brandonbraun653/OrbitESC/.kilo/commands/review-diff.md

---
name: review-diff
description: Review the current staged or unstaged diff with the RDD Reviewer.
argument-hint: Optionally specify staged, unstaged, or a path
agent: RDD Reviewer
---

Review current diff if no explicit files provided.

- Keep standard seven-dimension review format.
- Scope findings to diff + directly adjacent evidence.
- Targeted read-only analysis or narrow tests only when they reduce uncertainty.
- Surface req, tagging, traceability regressions alongside normal quality findings.
