brandonbraun653/OrbitESC/notebook/attachments/Pasted image 20251213105923.png

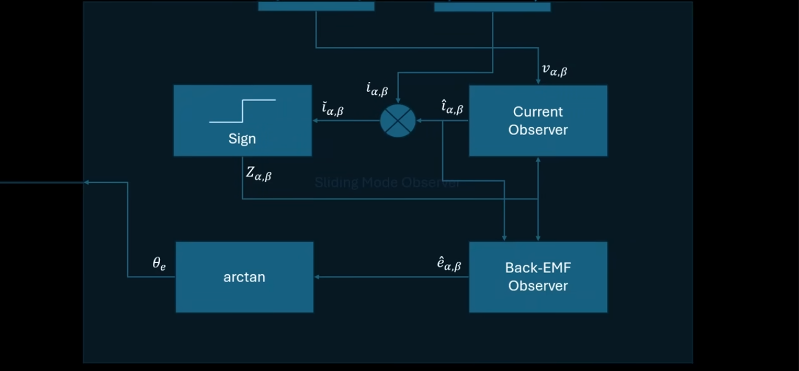
notebook/attachments/Pasted image 20251213105923.png
