brandonbraun653/OrbitESC/notebook/attachments/Pasted image 20251213110534.png

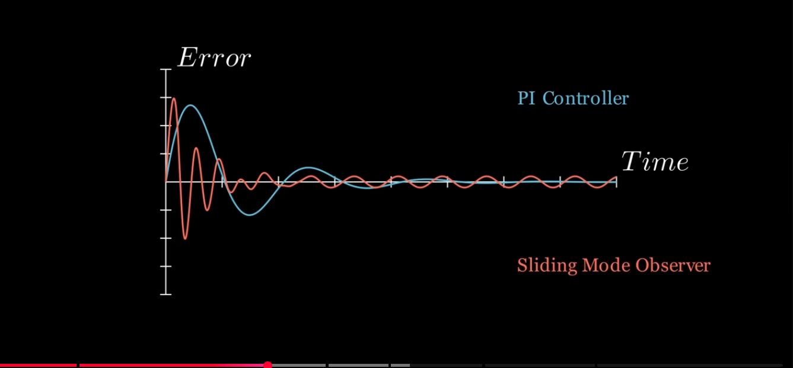
notebook/attachments/Pasted image 20251213110534.png
