brandonbraun653/OrbitESC/hw/pcb/OrbitESC_V3/validation/OrbitESC_BOMCheckList.ods

Reference | Value | Footprint | DigiKey | LCSC | Qty
U7 | AP62200Z6-7 | Package_TO_SOT_SMD:SOT-563 | 31-AP62200Z6-7CT-ND | C2158024 | 1
U4, U6, U13, U14 | TLV9051IDBVR | Package_TO_SOT_SMD:SOT-23-5 |  | C1849429 | 4
C18 | 10uF | Capacitor_SMD:C_0805_2012Metric |  | C440198 | 1
C1, C6, C7, C11, C12, C16, C17, C24, C28, C34-C37, C39-C43, C47-C49 | 100nF | Capacitor_SMD:C_0402_1005Metric |  | C307331 | 21
D5, D6 | Green LED | Diode_SMD:D_0603_1608Metric |  | C72043 | 2
D1 | Blue LED | Diode_SMD:D_0603_1608Metric |  | C72041 | 1
D4, D9 | Yellow LED | Diode_SMD:D_0603_1608Metric |  | C72038 | 2
U3 | STM32F446RETx | Package_QFP:LQFP-64_10x10mm_P0.5mm |  | C69336 | 1
L3 | 100uH | Inductor_SMD:L_0805_2012Metric |  | C68035 | 1
C30, C44 | 1uF | Capacitor_SMD:C_0402_1005Metric |  | C52923 | 2
C19-C21 | 2.2uF | Capacitor_SMD:C_0805_2012Metric |  | C49217 | 3
R9, R13, R46, R48, R50 | 5.1k | Resistor_SMD:R_0402_1005Metric |  | C25905 | 5
R24, R52, R66 | 1.5k | Resistor_SMD:R_0402_1005Metric |  | C25867 | 3
R40, R56 | 56k | Resistor_SMD:R_0402_1005Metric |  | C25796 | 2
R45, R49, R51 | 39k | Resistor_SMD:R_0402_1005Metric |  | C25783 | 3
R1, R19, R20, R23, R29-R31, R34, R37, R38, R41-R44, R47, R53-R55, R59, R62, R64 | 10k | Resistor_SMD:R_0402_1005Metric |  | C25744 | 21
R21, R22, R57 | 100k | Resistor_SMD:R_0402_1005Metric |  | C25741 | 3
R7, R58 | 470 | Resistor_SMD:R_0402_1005Metric |  | C25117 | 2
R11 | 33 | Resistor_SMD:R_0402_1005Metric |  | C25105 | 1
R2, R4, R8, R10, R14, R16 | 1 | Resistor_SMD:R_0402_1005Metric |  | C25086 | 6
R15 | 120 | Resistor_SMD:R_0402_1005Metric |  | C25079 | 1
C8, C46 | 4.7uF | Capacitor_SMD:C_0402_1005Metric |  | C23733 | 2
C10, C25, C26 | 47uF | Capacitor_SMD:C_0805_2012Metric |  | C16780 | 3
C3, C15, C27, C29 | 2.2uF | Capacitor_SMD:C_0402_1005Metric |  | C12530 | 4
R17, R32, R33, R35, R36, R39, R60, R61, R65 | 1k | Resistor_SMD:R_0402_1005Metric |  | C11702 | 9
D3, D8 | B5819W | Diode_SMD:D_SOD-123 |  | C8598 | 2
Q7 | 2N7002 | Package_TO_SOT_SMD:SOT-23 |  | C8545 | 1
R5 | 2.0k | Resistor_SMD:R_0402_1005Metric |  | C4109 | 1
D7 | Red LED | Diode_SMD:D_0603_1608Metric |  | C2286 | 1
C14 | 33nF | Capacitor_SMD:C_0402_1005Metric |  | C1585 | 1
C9, C13, C22 | 4.7nF | Capacitor_SMD:C_0402_1005Metric |  | C1538 | 3
C2, C5, C45 | 1nF | Capacitor_SMD:C_0402_1005Metric |  | C1523 | 3
FB1 | FerriteBead_Small | Resistor_SMD:R_0603_1608Metric |  | C1002 | 1
X1 | ASE-24MHz | Oscillator:Oscillator_SMD_Abracon_ASE-4Pin_3.2x2.5mm | 535-ASE-24.000MHZ-L-C-TCT-ND |  | 1
U9 | AP2120 | Package_TO_SOT_SMD:SOT-23 | AP2120N-3.3TRG1DICT-ND |  | 1 | Already Have
U8 | AP2171W | Package_TO_SOT_SMD:SOT-23-5 | AP2171WGDICT-ND |  | 1 | Already Have
U5 | DRV8300DRGER | Package_DFN_QFN:VQFN-24-1EP_4x4mm_P0.5mm_EP2.45x2.45mm | 296-DRV8300DRGERCT-ND |  | 1 | Already Have
U2 | AT25SF128A-SHB-T | Package_SO:SOIC-8_3.9x4.9mm_P1.27mm | 1265-1348-1-ND |  | 1
U1 | TLE9250X | Package_SON:HVSON-8-1EP_3x3mm_P0.65mm_EP1.6x2.4mm | 448-TLE9250XLEXUMA1CT-ND |  | 1 | Already Have
TP19 | CL | TestPoint:TestPoint_Pad_D1.0mm | N/A |  | 1
TP18 | CH | TestPoint:TestPoint_Pad_D1.0mm | N/A |  | 1
TP17 | BL | TestPoint:TestPoint_Pad_D1.0mm | N/A |  | 1
TP16 | BH | TestPoint:TestPoint_Pad_D1.0mm | N/A |  | 1
TP15 | AL | TestPoint:TestPoint_Pad_D1.0mm | N/A |  | 1
TP14 | AH | TestPoint:TestPoint_Pad_D1.0mm | N/A |  | 1
TH1 | 10k | Resistor_SMD:R_0402_1005Metric | 445-2550-1-ND |  | 1
SW2 | DFU | Button_Switch_SMD:SW_SPST_EVQP2 | P11081SCT-ND |  | 1
SW1 | Reset | Button_Switch_SMD:SW_SPST_EVQP2 | P11081SCT-ND |  | 1
R6, R12, R63 | 0.01 | Resistor_SMD:R_2512_6332Metric | CRA2512-FZ-R010ELFCT-ND |  | 3 | Already Have
Q1-Q6 | MCAC100N08YA-TP | Project Mosfets:TRANS_BSC076N06NS3-G | 353-MCAC100N08YA-TPCT-ND |  | 6 | Already Have
L2 | 220uH | Inductor_SMD:L_1812_4532Metric_Pad1.30x3.40mm_HandSolder | CM453232-221KLCT-ND |  | 1
L1 | 4.7uH | Inductor_SMD:L_Bourns-SRN6028 | 587-2100-1-ND |  | 1 | Already Have
J13 | RX | TestPoint:TestPoint_Pad_1.5x1.5mm | N/A |  | 1
J12 | GND | TestPoint:TestPoint_Pad_2.5x2.5mm | N/A |  | 1
J11 | VDC | TestPoint:TestPoint_Pad_2.5x2.5mm | N/A |  | 1
J10 | ~ | Connector_PinHeader_1.27mm:PinHeader_2x05_P1.27mm_Vertical | 609-3712-ND |  | 1 | Already Have
J9 | TX | TestPoint:TestPoint_Pad_1.5x1.5mm | N/A |  | 1
J8 | Micro_SD_Card_Det2 | Connector_Card:microSD_HC_Hirose_DM3D-SF | HR1941CT-ND |  | 1
J7 | CANL | TestPoint:TestPoint_Pad_1.5x1.5mm | N/A |  | 1
J6 | GND | TestPoint:TestPoint_Pad_1.5x1.5mm | N/A |  | 1
J5 | TermC | TestPoint:TestPoint_Pad_2.5x2.5mm | N/A |  | 1
J4 | TermB | TestPoint:TestPoint_Pad_2.5x2.5mm | N/A |  | 1
J3 | TermA | TestPoint:TestPoint_Pad_2.5x2.5mm | N/A |  | 1
J2 | CANH | TestPoint:TestPoint_Pad_1.5x1.5mm | N/A |  | 1
J1 | USB_C_Receptacle_USB2.0 | Connector_USB:USB_C_Receptacle_GCT_USB4085 | 2073-USB4085-GF-ACT-ND |  | 1 | Already Have
D2 | 18v | Diode_SMD:D_SMA | SMAZ18-FDICT-ND |  | 1 | Already Have
C31, C33 | 47uF | Capacitor_SMD:C_1206_3216Metric | 445-8047-1-ND |  | 2
