brandonbraun653/OrbitESC/hw/pcb/OrbitESC_V3/OrbitESC.kicad_pcb

## KiCad design hw/pcb/OrbitESC_V3/OrbitESC.kicad_pcb (2023-06-14)

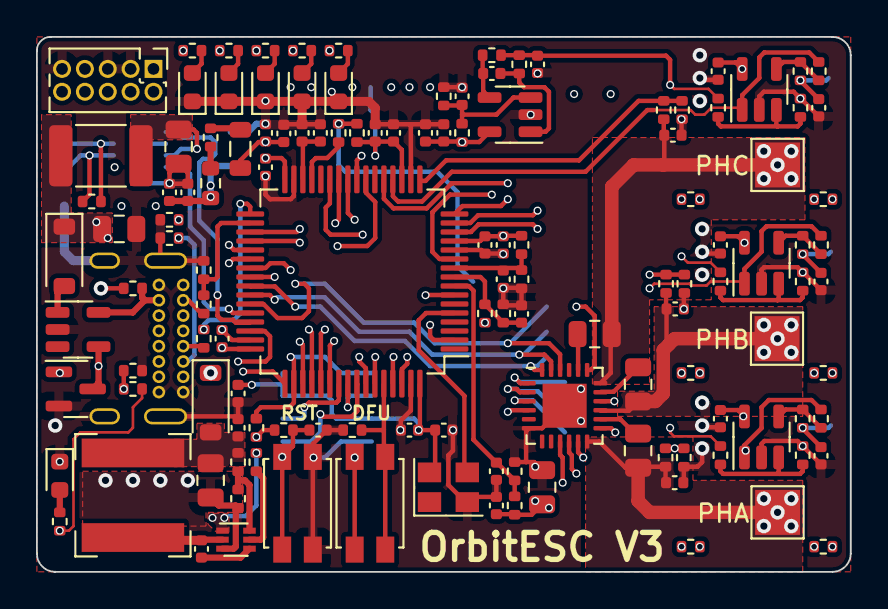
[picture p4: board hw/pcb/OrbitESC_V3/OrbitESC.kicad_pcb from above]

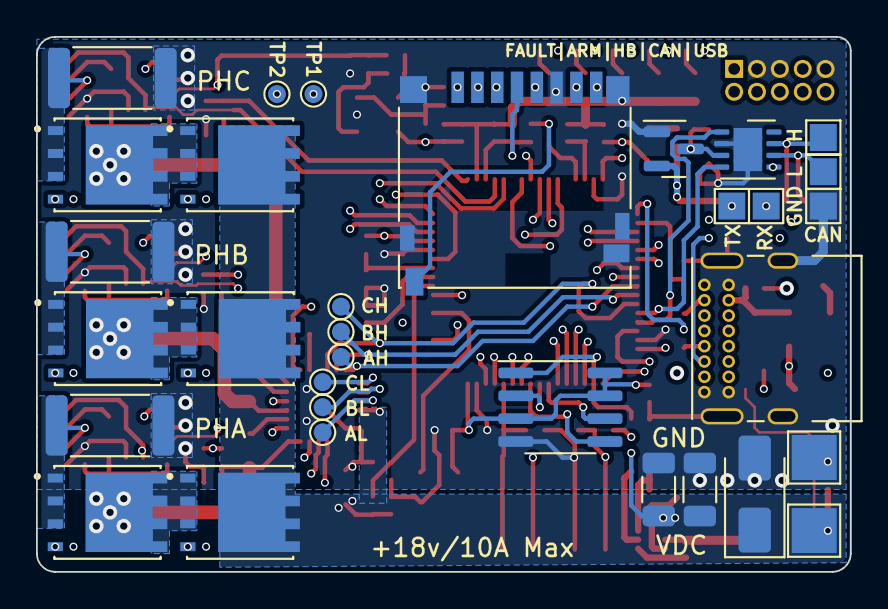
[picture p5: board hw/pcb/OrbitESC_V3/OrbitESC.kicad_pcb from below]

Board: 8 copper layers, 45.2 x 29.7 mm, 161 parts (32 on the bottom side), 106 nets.

Parts:
C1, C6, C7, C11, C12, C16, C17, C24, C28, C34, C35, C36, C37, C39, C40, C41, C42, C43, C47, C48, C49: 100nF; C_0402_1005Metric
C2, C5, C45: 1nF; C_0402_1005Metric
C3, C15, C27, C29: 2.2uF; C_0402_1005Metric
C8, C46: 4.7uF; C_0402_1005Metric
C9, C13, C22: 4.7nF; C_0402_1005Metric
C10, C25, C26: 47uF; C_0805_2012Metric
C14: 33nF; C_0402_1005Metric
C18: 10uF; C_0805_2012Metric
C19, C20, C21: 2.2uF; C_0805_2012Metric
C30, C44: 1uF; C_0402_1005Metric
C31, C33: 47uF; C_1206_3216Metric
D1: Blue LED; D_0603_1608Metric
D2: 18v; D_SMA
D3, D8: B5819W; D_SOD-123
D4, D9: Yellow LED; D_0603_1608Metric
D5, D6: Green LED; D_0603_1608Metric
D7: Red LED; D_0603_1608Metric
FB1: FerriteBead_Small; R_0603_1608Metric
J1: USB_C_Receptacle_USB2.0; USB_C_Receptacle_GCT_USB4085
J2: CANH; TestPoint_Pad_1.5x1.5mm
J3: TermA; TestPoint_Pad_2.5x2.5mm
J4: TermB; TestPoint_Pad_2.5x2.5mm
J5: TermC; TestPoint_Pad_2.5x2.5mm
J6: GND; TestPoint_Pad_1.5x1.5mm
J7: CANL; TestPoint_Pad_1.5x1.5mm
J8: Micro_SD_Card_Det2; microSD_HC_Hirose_DM3D-SF
J9: TX; TestPoint_Pad_1.5x1.5mm
J10: PinHeader_2x05_P1.27mm_Vertical
J11: VDC; TestPoint_Pad_2.5x2.5mm
J12: GND; TestPoint_Pad_2.5x2.5mm
J13: RX; TestPoint_Pad_1.5x1.5mm
L1: 4.7uH; L_Bourns-SRN6028
L2: 220uH; L_1812_4532Metric_Pad1.30x3.40mm_HandSolder
L3: 100uH; L_0805_2012Metric
Q1, Q2, Q3, Q4, Q5, Q6: MCAC100N08YA-TP; TRANS_BSC076N06NS3-G
Q7: 2N7002; SOT-23
R1, R19, R20, R23, R29, R30, R31, R34, R37, R38, R41, R42, R43, R44, R47, R53, R54, R55, R59, R62, R64: 10k; R_0402_1005Metric
R2, R4, R8, R10, R14, R16: 1; R_0402_1005Metric
R5: 2.0k; R_0402_1005Metric
R6, R12, R63: 0.01; R_2512_6332Metric
R7, R58: 470; R_0402_1005Metric
R9, R13, R46, R48, R50: 5.1k; R_0402_1005Metric
R11: 33; R_0402_1005Metric
R15: 120; R_0402_1005Metric
R17, R32, R33, R35, R36, R39, R60, R61, R65: 1k; R_0402_1005Metric
R21, R22, R57: 100k; R_0402_1005Metric
R24, R52, R66: 1.5k; R_0402_1005Metric
R40, R56: 56k; R_0402_1005Metric
R45, R49, R51: 39k; R_0402_1005Metric
SW1: Reset; SW_SPST_EVQP2
SW2: DFU; SW_SPST_EVQP2
TH1: 10k; R_0402_1005Metric
TP1, TP2, TP18: CH; TestPoint_Pad_D1.0mm
TP14: AH; TestPoint_Pad_D1.0mm
TP15: AL; TestPoint_Pad_D1.0mm
TP16: BH; TestPoint_Pad_D1.0mm
TP17: BL; TestPoint_Pad_D1.0mm
TP19: CL; TestPoint_Pad_D1.0mm
U1: TLE9250X; HVSON-8-1EP_3x3mm_P0.65mm_EP1.6x2.4mm
U2: AT25SF128A-SHB-T; SOIC-8_3.9x4.9mm_P1.27mm
U3: STM32F446RETx; LQFP-64_10x10mm_P0.5mm
U4, U6, U13, U14: TLV9051IDBVR; SOT-23-5
U5: DRV8300DRGER; VQFN-24-1EP_4x4mm_P0.5mm_EP2.45x2.45mm
U7: AP62200Z6-7; SOT-563
U8: AP2171W; SOT-23-5
U9: AP2120; SOT-23
X1: ASE-24MHz; Oscillator_SMD_Abracon_ASE-4Pin_3.2x2.5mm

Connections:
+3.3V: C7.2, C8.2, C29.2, C35.2, C36.1, C39.2, C41.2, C48.2, C49.2, FB1.1, J8.4 (VDD), J10.1, R1.2, R54.2, R55.2, R64.2, SW2.1, U1.5 (VIO), U2.3 (~WP/IO2), U2.7 (~HOLD/IO3), U2.8 (VCC), U3.19 (VDD), U3.32 (VDD), U3.48 (VDD), U3.64 (VDD), U9.2 (VO), X1.4 (Vdd)
+3.3VADC: C11.2, C12.2, C15.2, C16.1, C27.2, C28.1, C40.1, C42.1, C43.1, L3.2, R21.2, TH1.1, U3.13 (VDDA), U4.5 (V+), U6.5 (V+), U13.5 (V+), U14.5 (V+)
+5V: C10.1, L2.2, U1.3 (VCC), U9.3 (VI)
/MCU/GATE_DRIVE_AH: TP18.1, U3.41 (PA8), U5.24 (INHC)
/MCU/GATE_DRIVE_AL: TP19.1, U3.23 (PA7), U5.3 (INLC)
/MCU/GATE_DRIVE_BH: TP16.1, U3.42 (PA9), U5.23 (INHB)
/MCU/GATE_DRIVE_BL: TP17.1, U3.26 (PB0), U5.2 (INLB)
/MCU/GATE_DRIVE_CH: TP14.1, U3.43 (PA10), U5.22 (INHA)
/MCU/GATE_DRIVE_CL: TP15.1, U3.27 (PB1), U5.1 (INLA)
/MCU/MOTOR_IA: R34.1, U3.14 (PA0), U14.1
/MCU/MOTOR_IB: R31.1, U3.16 (PA2), U13.1
/MCU/MOTOR_IC: R59.1, U3.20 (PA4), U6.1
/MCU/MOTOR_VA: R45.1, R46.1, U3.15 (PA1)
/MCU/MOTOR_VB: R48.1, R49.1, U3.21 (PA5)
/MCU/MOTOR_VC: R50.1, R51.1, U3.17 (PA3)
/Outputs and Shunts/A_ISENSE_P: C2.1, Q2.3 (S), R6.1, R35.1
/Outputs and Shunts/B_ISENSE_P: C5.1, Q4.3 (S), R12.1, R32.1
/Outputs and Shunts/C_ISENSE_P: C45.1, Q6.3 (S), R60.1, R63.1
/Outputs and Shunts/GDH_A: R2.1, U5.13 (GHC)
/Outputs and Shunts/GDH_B: R8.1, U5.16 (GHB)
/Outputs and Shunts/GDH_C: R14.1, U5.19 (GHA)
/Outputs and Shunts/GDL_A: R4.1, U5.9 (GLC)
/Outputs and Shunts/GDL_B: R10.1, U5.10 (GLB)
/Outputs and Shunts/GDL_C: R16.1, U5.11 (GLA)
/Outputs and Shunts/SH_A: C9.2, C21.2, J3.1, Q1.3 (S), Q2.1 (D), R45.2, U5.12 (SHC)
/Outputs and Shunts/SH_B: C13.2, C20.2, J4.1, Q3.3 (S), Q4.1 (D), R49.2, U5.15 (SHB)
/Outputs and Shunts/SH_C: C19.2, C22.2, J5.1, Q5.3 (S), Q6.1 (D), R51.2, U5.18 (SHA)
ArmedLED: R29.1, U3.58 (PB6)
CAN1_RXD: U1.4 (RxD), U3.44 (PA11)
CAN1_TXD: U1.1 (TxD), U3.45 (PA12)
CANActiveLED: R7.1, U3.61 (PB8)
FaultLED: R52.1, U3.2 (PC13)
GND: C1.1, C2.2, C3.1, C5.2, C6.2, C7.1, C8.1, C9.1, C10.2, C11.1, C12.1, C13.1, C15.1, C16.2, C17.1, C18.2, C22.1, C25.2, C26.2, C27.1, C28.2, C29.1, C30.2, C31.2, C33.2, C34.2, C35.1, C36.2, C37.2, C39.1, C40.2, C41.1, C42.2, C43.2, C44.2, C45.2, C46.1, C47.2, C48.1, C49.1, D1.1 (K), D2.2 (A), D4.1 (K), D5.1 (K), D6.1 (K), D7.1 (K), D9.1 (K), J1.A1 (GND), J1.A12 (GND), J1.B1 (GND), J1.B12 (GND), J1.S1 (SHIELD), J6.1, J8.6 (VSS), J8.9 (DET_B), J8.11 (SHIELD), J10.3, J10.5, J10.9, J12.1, Q7.2 (S), R6.2, R9.1, R12.2, R13.2, R20.1, R22.1, R24.2, R33.1, R36.1, R38.1, R41.1, R42.1, R46.2, R48.2, R50.2, R53.1, R57.2, R61.1, R63.2, SW1.2, U1.2 (GND), U1.9 (PAD), U2.4 (GND), U3.12 (VSSA), U3.18 (VSS), U3.31 (VSS), U3.47 (VSS), U3.63 (VSS), U4.2 (V-), U5.6 (GND), U5.25 (PAD), U6.2 (V-), U7.3 (GND), U8.2 (GND), U9.1 (GND), U13.2 (V-), U14.2 (V-), X1.2 (GND)
HeartbeatLED: R19.1, U3.59 (PB7)
ISenseVRef: C30.1, R5.1, R11.1, R30.2, R47.2, R62.2, U3.11 (PC3)
NOR_MISO: U2.2 (SO/IO1), U3.56 (PB4)
NOR_MOSI: U2.5 (SI/IO0), U3.57 (PB5)
NOR_SCK: U2.6 (SCK), U3.55 (PB3)
NOR_nCS: R55.1, U2.1 (~CS), U3.50 (PA15)
unnamed: C14.2, R11.2, U4.1
unnamed: D1.2 (A), R43.2
unnamed: D3.2 (A), U8.1 (OUT)
unnamed: D4.2 (A), R7.2
unnamed: D5.2 (A), R19.2
unnamed: D6.2 (A), R29.2
unnamed: D7.2 (A), R52.2
unnamed: C25.1, C34.1, D8.2 (A), L1.2, R40.1
unnamed: D9.2 (A), R58.2
unnamed: FB1.2, R17.1
unnamed: J1.A5 (CC1), R9.2
unnamed: J1.B5 (CC2), R13.1
unnamed: J2.1, R15.2, U1.7 (CANH)
unnamed: J7.1, R15.1, U1.6 (CANL)
unnamed: J8.10 (DET_A), R64.1, R65.2
unnamed: L3.1, R17.2
unnamed: Q1.2 (G), R2.2
unnamed: Q2.2 (G), R4.2
unnamed: Q3.2 (G), R8.2
unnamed: Q4.2 (G), R10.2
unnamed: Q5.2 (G), R14.2
unnamed: Q6.2 (G), R16.2
unnamed: Q7.3 (D), R44.2, U8.4 (EN)
unnamed: Q7.1 (G), R38.2, R39.2
unnamed: TP1.1, U3.24 (PC4)
unnamed: TP2.1, U3.25 (PC5)
unnamed: U3.5 (PH0), X1.3 (OUT)
unnamed: C46.2, C47.1, U3.30 (VCAP_1)
unnamed: C44.1, R21.1, R22.2, U4.3 (+)
unnamed: C14.1, R5.2, U4.4 (-)
unnamed: C19.1, U5.20 (BSTA)
unnamed: C20.1, U5.17 (BSTB)
unnamed: C21.1, U5.14 (BSTC)
unnamed: R61.2, R62.1, U6.3 (+)
unnamed: R59.2, R60.2, U6.4 (-)
unnamed: C24.2, U7.4 (BST)
unnamed: R37.2, U7.5 (EN)
unnamed: R40.2, R41.2, U7.6 (FB)
unnamed: C24.1, L1.1, U7.2 (SW)
unnamed: R30.1, R33.2, U13.3 (+)
unnamed: R31.2, R32.2, U13.4 (-)
unnamed: R36.2, R47.1, U14.3 (+)
unnamed: R34.2, R35.2, U14.4 (-)
SDIO_CLK: J8.5 (CLK), U3.53 (PC12)
SDIO_CMD: J8.3 (CMD), U3.54 (PD2)
SDIO_D0: J8.7 (DAT0), U3.39 (PC8)
SDIO_D1: J8.8 (DAT1), U3.40 (PC9)
SDIO_D2: J8.1 (DAT2), U3.51 (PC10)
SDIO_D3: J8.2 (DAT3/CD), U3.52 (PC11)
SDIO_DETECT: R65.1, U3.29 (PB10)
SERIAL1_IN: J13.1, U3.38 (PC7)
SERIAL1_OUT: J9.1, U3.37 (PC6)
SWCLK: J10.4, U3.49 (PA14)
SWDIO: J10.2, U3.46 (PA13)
USBActiveLED: R58.1, U3.62 (PB9)
USB_D+: J1.A6 (D+), J1.B6 (D+), R66.2, U3.36 (PB15)
USB_D-: J1.A7 (D-), J1.B7 (D-), U3.35 (PB14)
USB_ENUM: R66.1, U3.33 (PB12)
USB_VBUS: R56.2, R57.1, U3.34 (PB13)
VBUS: J1.A4 (VBUS), J1.A9 (VBUS), J1.B4 (VBUS), J1.B9 (VBUS), R44.1, R56.1, U8.5 (IN)
VDC: C17.2, C18.1, C31.1, C33.1, D2.1 (K), J11.1, Q1.1 (D), Q3.1 (D), Q5.1 (D), R23.2, R37.1, R39.1, R43.1, U5.4 (GVDD), U7.1 (VIN)
VDD: C26.1, D3.1 (K), D8.1 (K), L2.1
VMCU: C37.1, R53.2, R54.1, U3.9 (PC1)
VSUPPLY: C6.1, R23.1, R24.1, U3.8 (PC0)
VTEMP: C3.2, R20.2, TH1.2, U3.10 (PC2)
nDFU_BOOT: R42.2, SW2.2, U3.60 (BOOT0)
nRESET: C1.2, J10.10, R1.1, SW1.1, U3.7 (NRST)
