brandonbraun653/OrbitESC/hw/pcb/OrbitESC/OrbitESC.kicad_pcb

## KiCad design hw/pcb/OrbitESC/OrbitESC.kicad_pcb (2023-06-14, an earlier design)

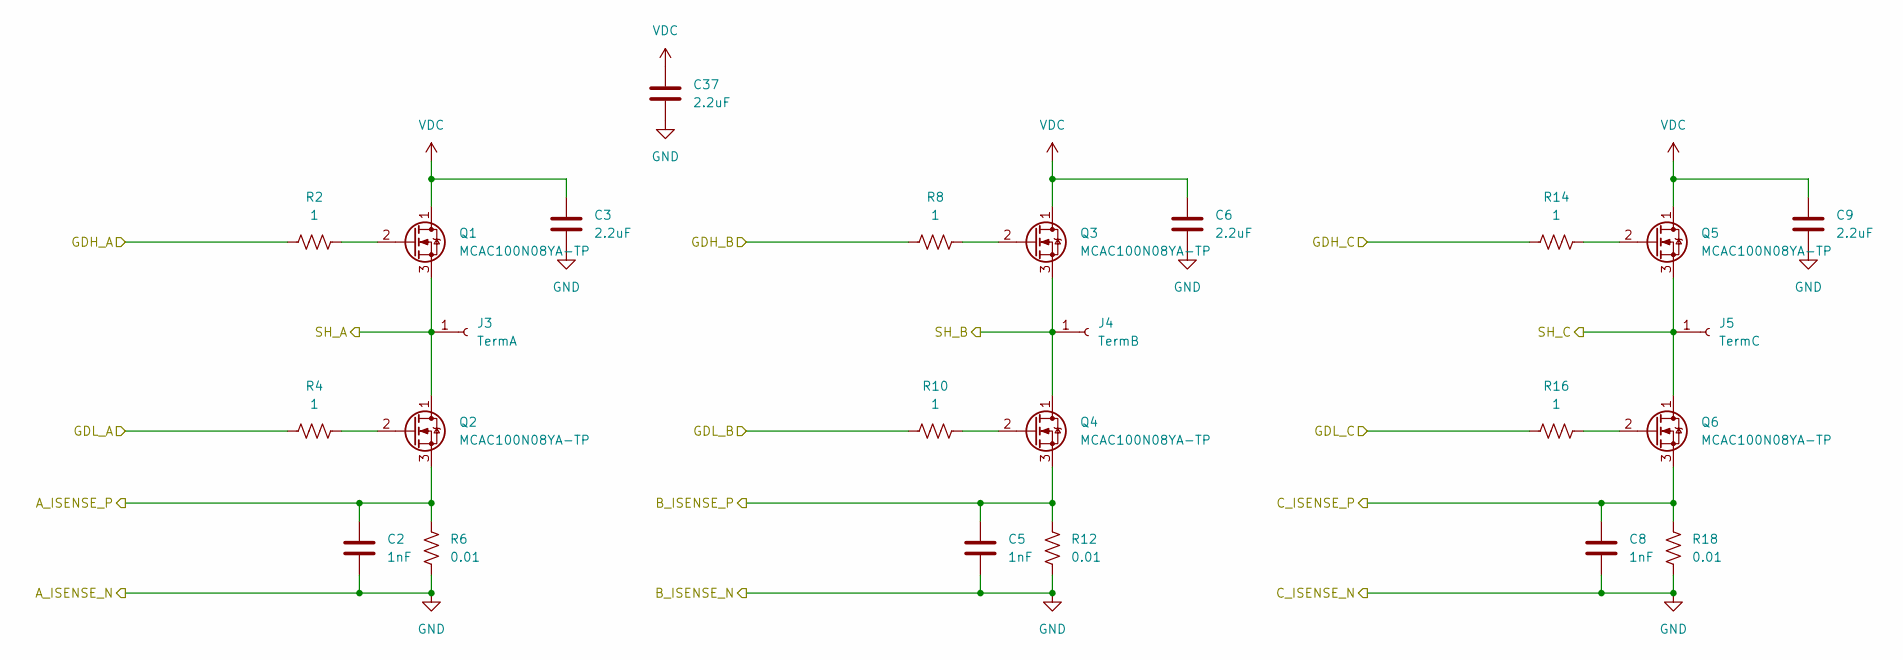
[picture p6: schematic output_stage.kicad_sch]

Parts:
C2, C5, C8: 1nF; C_0402_1005Metric; LCSC C1523
C3, C6, C9, C37: 2.2uF; C_0805_2012Metric; LCSC C49217
J3: TermA; TestPoint_Pad_4.0x4.0mm; DigiKey N/A
J4: TermB; TestPoint_Pad_4.0x4.0mm; DigiKey N/A
J5: TermC; TestPoint_Pad_4.0x4.0mm; DigiKey N/A
Q1, Q2, Q3, Q4, Q5, Q6: MCAC100N08YA-TP; TRANS_BSC076N06NS3-G; DigiKey 353-MCAC100N08YA-TPCT-ND
R2, R4, R8, R10, R14, R16: 1; R_0402_1005Metric; LCSC C25086
R6, R12, R18: 0.01; R_2512_6332Metric; DigiKey CRA2512-FZ-R010ELFCT-ND

Connections:
/Outputs and Shunts/A_ISENSE_P: C2.1, Q2.3 (S), R6.1; also elsewhere on the board
/Outputs and Shunts/B_ISENSE_P: C5.1, Q4.3 (S), R12.1; also elsewhere on the board
/Outputs and Shunts/C_ISENSE_P: C8.1, Q6.3 (S), R18.1; also elsewhere on the board
/Outputs and Shunts/GDH_A: R2.1; also elsewhere on the board
/Outputs and Shunts/GDH_B: R8.1; also elsewhere on the board
/Outputs and Shunts/GDH_C: R14.1; also elsewhere on the board
/Outputs and Shunts/GDL_A: R4.1; also elsewhere on the board
/Outputs and Shunts/GDL_B: R10.1; also elsewhere on the board
/Outputs and Shunts/GDL_C: R16.1; also elsewhere on the board
/Outputs and Shunts/SH_A: J3.1, Q1.3 (S), Q2.1 (D); also elsewhere on the board
/Outputs and Shunts/SH_B: J4.1, Q3.3 (S), Q4.1 (D); also elsewhere on the board
/Outputs and Shunts/SH_C: J5.1, Q5.3 (S), Q6.1 (D); also elsewhere on the board
GND: C2.2, C3.2, C5.2, C6.2, C8.2, C9.2, C37.2, R6.2, R12.2, R18.2; also elsewhere on the board
unnamed: Q1.2 (G), R2.2
unnamed: Q2.2 (G), R4.2
unnamed: Q3.2 (G), R8.2
unnamed: Q4.2 (G), R10.2
unnamed: Q5.2 (G), R14.2
unnamed: Q6.2 (G), R16.2
VDC: C3.1, C6.1, C9.1, C37.1, Q1.1 (D), Q3.1 (D), Q5.1 (D); also elsewhere on the board

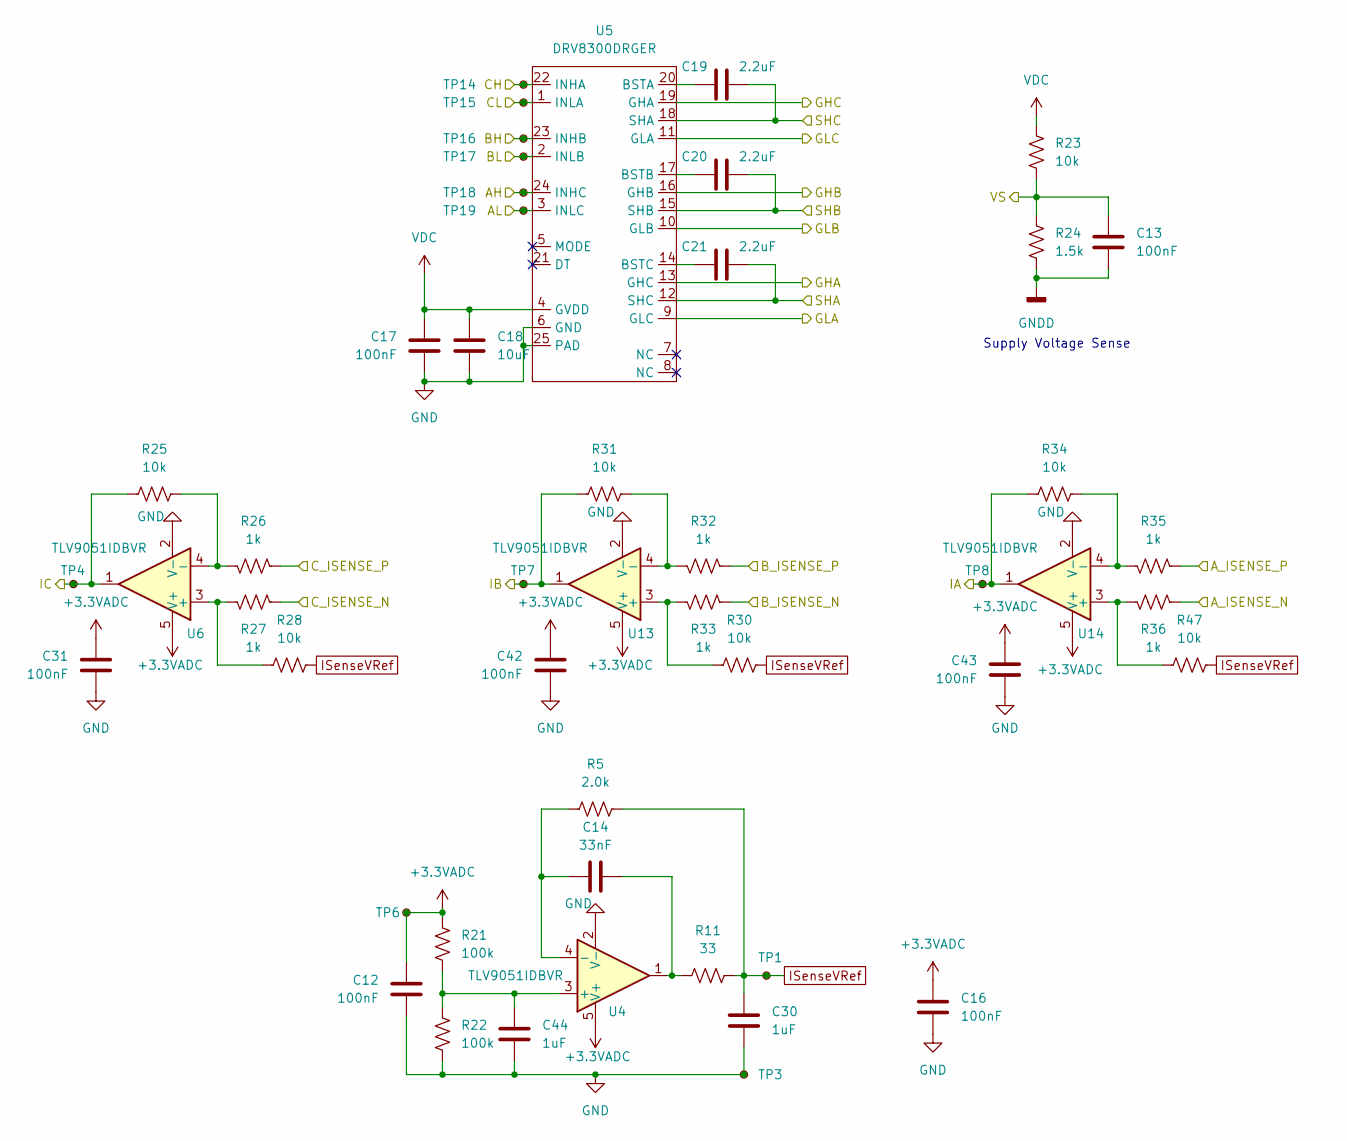
[picture p7: schematic power_stage.kicad_sch]

Parts:
C12, C13, C16, C17, C31, C42, C43: 100nF; C_0402_1005Metric; LCSC C307331
C14: 33nF; C_0402_1005Metric; LCSC C1585
C18: 10uF; C_0805_2012Metric; LCSC C440198
C19, C20, C21: 2.2uF; C_0805_2012Metric; LCSC C49217
C30, C44: 1uF; C_0402_1005Metric; LCSC C52923
R5: 2.0k; R_0402_1005Metric; LCSC C4109
R11: 33; R_0402_1005Metric; LCSC C25105
R21, R22: 100k; R_0402_1005Metric; LCSC C25741
R23, R25, R28, R30, R31, R34, R47: 10k; R_0402_1005Metric; LCSC C25744
R24: 1.5k; R_0402_1005Metric; LCSC C25867
R26, R27, R32, R33, R35, R36: 1k; R_0402_1005Metric; LCSC C11702
TP1, TP3, TP17: BL; TestPoint_Pad_D1.0mm
TP4, TP6, TP7, TP8, TP14: AH; TestPoint_Pad_D1.0mm
TP15: AL; TestPoint_Pad_D1.0mm
TP16: BH; TestPoint_Pad_D1.0mm
TP18: CH; TestPoint_Pad_D1.0mm
TP19: CL; TestPoint_Pad_D1.0mm
U4, U6, U13, U14: TLV9051IDBVR; SOT-23-5; LCSC C1849429
U5: DRV8300DRGER; VQFN-24-1EP_4x4mm_P0.5mm_EP2.45x2.45mm; DigiKey 296-DRV8300DRGERCT-ND

Connections:
+3.3VADC: C12.2, C16.1, C31.1, C42.1, C43.1, R21.2, TP6.1, U4.5 (V+), U6.5 (V+), U13.5 (V+), U14.5 (V+); also elsewhere on the board
/MCU/GATE_DRIVE_AH: TP18.1, U5.24 (INHC); also elsewhere on the board
/MCU/GATE_DRIVE_AL: TP19.1, U5.3 (INLC); also elsewhere on the board
/MCU/GATE_DRIVE_BH: TP16.1, U5.23 (INHB); also elsewhere on the board
/MCU/GATE_DRIVE_BL: TP17.1, U5.2 (INLB); also elsewhere on the board
/MCU/GATE_DRIVE_CH: TP14.1, U5.22 (INHA); also elsewhere on the board
/MCU/GATE_DRIVE_CL: TP15.1, U5.1 (INLA); also elsewhere on the board
/MCU/INPUT_VOLTAGE: C13.1, R23.1, R24.1; also elsewhere on the board
/MCU/MOTOR_IA: R34.1, TP8.1, U14.1; also elsewhere on the board
/MCU/MOTOR_IB: R31.1, TP7.1, U13.1; also elsewhere on the board
/MCU/MOTOR_IC: R25.1, TP4.1, U6.1; also elsewhere on the board
/Outputs and Shunts/A_ISENSE_P: R35.1; also elsewhere on the board
/Outputs and Shunts/B_ISENSE_P: R32.1; also elsewhere on the board
/Outputs and Shunts/C_ISENSE_P: R26.1; also elsewhere on the board
/Outputs and Shunts/GDH_A: U5.13 (GHC); also elsewhere on the board
/Outputs and Shunts/GDH_B: U5.16 (GHB); also elsewhere on the board
/Outputs and Shunts/GDH_C: U5.19 (GHA); also elsewhere on the board
/Outputs and Shunts/GDL_A: U5.9 (GLC); also elsewhere on the board
/Outputs and Shunts/GDL_B: U5.10 (GLB); also elsewhere on the board
/Outputs and Shunts/GDL_C: U5.11 (GLA); also elsewhere on the board
/Outputs and Shunts/SH_A: C21.2, U5.12 (SHC); also elsewhere on the board
/Outputs and Shunts/SH_B: C20.2, U5.15 (SHB); also elsewhere on the board
/Outputs and Shunts/SH_C: C19.2, U5.18 (SHA); also elsewhere on the board
GND: C12.1, C13.2, C16.2, C17.1, C18.2, C30.2, C31.2, C42.2, C43.2, C44.2, R22.1, R24.2, R27.1, R33.1, R36.1, TP3.1, U4.2 (V-), U5.6 (GND), U5.25 (PAD), U6.2 (V-), U13.2 (V-), U14.2 (V-); also elsewhere on the board
ISenseVRef: C30.1, R5.1, R11.1, R28.2, R30.2, R47.2, TP1.1
unnamed: C14.1, R5.2, U4.4 (-)
unnamed: C14.2, R11.2, U4.1
unnamed: C19.1, U5.20 (BSTA)
unnamed: C20.1, U5.17 (BSTB)
unnamed: C21.1, U5.14 (BSTC)
unnamed: C44.1, R21.1, R22.2, U4.3 (+)
unnamed: R25.2, R26.2, U6.4 (-)
unnamed: R27.2, R28.1, U6.3 (+)
unnamed: R30.1, R33.2, U13.3 (+)
unnamed: R31.2, R32.2, U13.4 (-)
unnamed: R34.2, R35.2, U14.4 (-)
unnamed: R36.2, R47.1, U14.3 (+)
VDC: C17.2, C18.1, R23.2, U5.4 (GVDD); also elsewhere on the board

Notes on the sheet:
Supply Voltage Sense

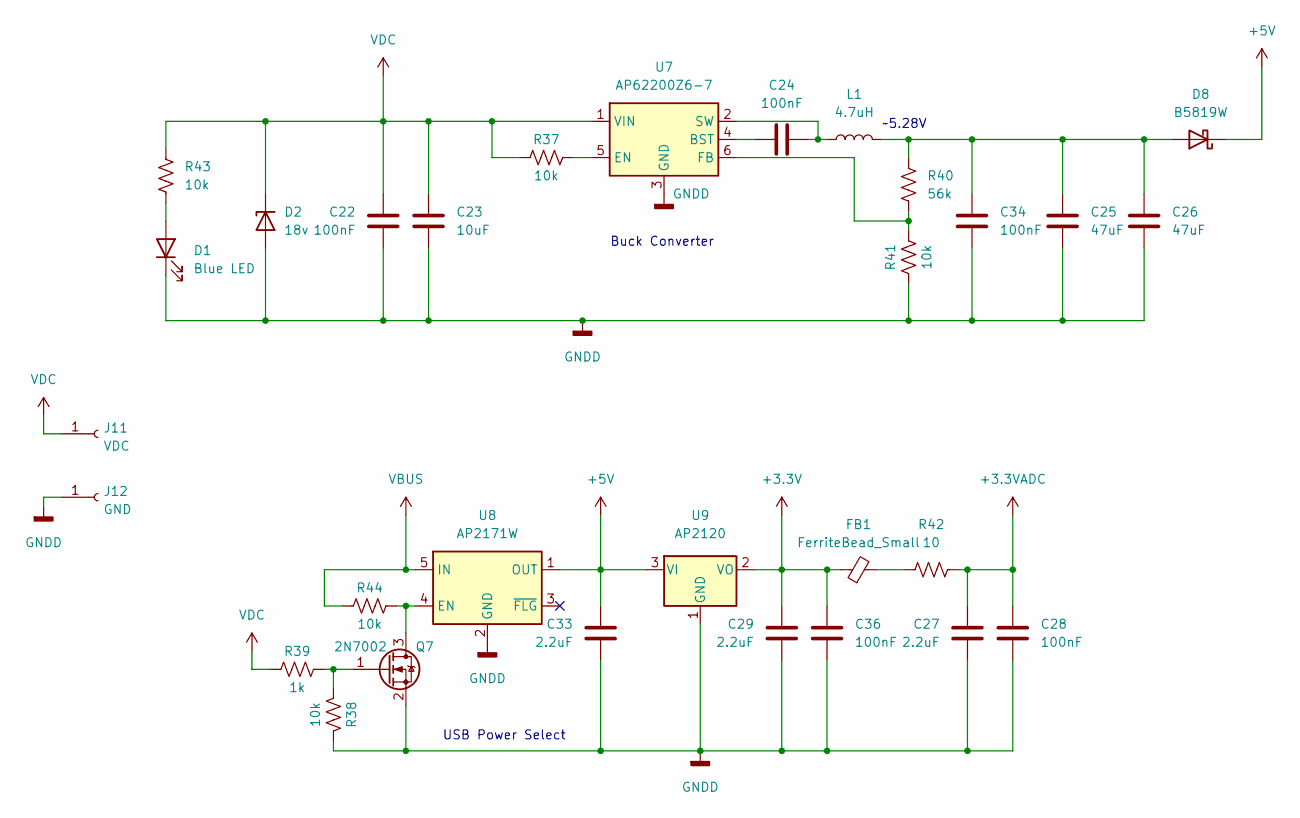
[picture p8: schematic power_supply.kicad_sch]

Parts:
C22, C24, C28, C34, C36: 100nF; C_0402_1005Metric; LCSC C307331
C23: 10uF; C_0805_2012Metric; LCSC C440198
C25, C26: 47uF; C_0805_2012Metric; LCSC C16780
C27, C29, C33: 2.2uF; C_0805_2012Metric; LCSC C49217
D1: Blue LED; D_0603_1608Metric; LCSC C72041
D2: 18v; D_SMA; DigiKey SMAZ18-FDICT-ND
D8: B5819W; D_SOD-123; LCSC C8598
FB1: FerriteBead_Small; R_0603_1608Metric; LCSC C1002
J11: VDC; TestPoint_Pad_4.0x4.0mm; DigiKey N/A
J12: GND; TestPoint_Pad_4.0x4.0mm; DigiKey N/A
L1: 4.7uH; L_Bourns-SRN6028; DigiKey 587-2100-1-ND
Q7: 2N7002; SOT-23; LCSC C8545
R37, R38, R41, R43, R44: 10k; R_0402_1005Metric; LCSC C25744
R39: 1k; R_0402_1005Metric; LCSC C11702
R40: 56k; R_0402_1005Metric; DigiKey RMCF0402FT57K6CT-ND
R42: 10; R_0402_1005Metric; LCSC C25077
U7: AP62200Z6-7; SOT-563; DigiKey 31-AP62200Z6-7CT-ND
U8: AP2171W; SOT-23-5; DigiKey AP2171WGDICT-ND
U9: AP2120; SOT-23; DigiKey AP2120N-3.3TRG1DICT-ND

Connections:
+3.3V: C29.2, C36.1, FB1.1, U9.2 (VO); also elsewhere on the board
+3.3VADC: C27.2, C28.1, R42.2; also elsewhere on the board
+5V: C33.2, D8.1 (K), U8.1 (OUT), U9.3 (VI); also elsewhere on the board
GND: C22.1, C23.2, C25.2, C26.2, C27.1, C28.2, C29.1, C33.1, C34.2, C36.2, D1.1 (K), D2.2 (A), J12.1, Q7.2 (S), R38.1, R41.1, U7.3 (GND), U8.2 (GND), U9.1 (GND); also elsewhere on the board
unnamed: C24.1, L1.1, U7.2 (SW)
unnamed: C24.2, U7.4 (BST)
unnamed: C25.1, C26.1, C34.1, D8.2 (A), L1.2, R40.1
unnamed: D1.2 (A), R43.2
unnamed: FB1.2, R42.1
unnamed: Q7.1 (G), R38.2, R39.2
unnamed: Q7.3 (D), R44.2, U8.4 (EN)
unnamed: R37.2, U7.5 (EN)
unnamed: R40.2, R41.2, U7.6 (FB)
VBUS: R44.1, U8.5 (IN); also elsewhere on the board
VDC: C22.2, C23.1, D2.1 (K), J11.1, R37.1, R39.1, R43.1, U7.1 (VIN); also elsewhere on the board

Notes on the sheet:
~5.28V
Buck Converter
USB Power Select

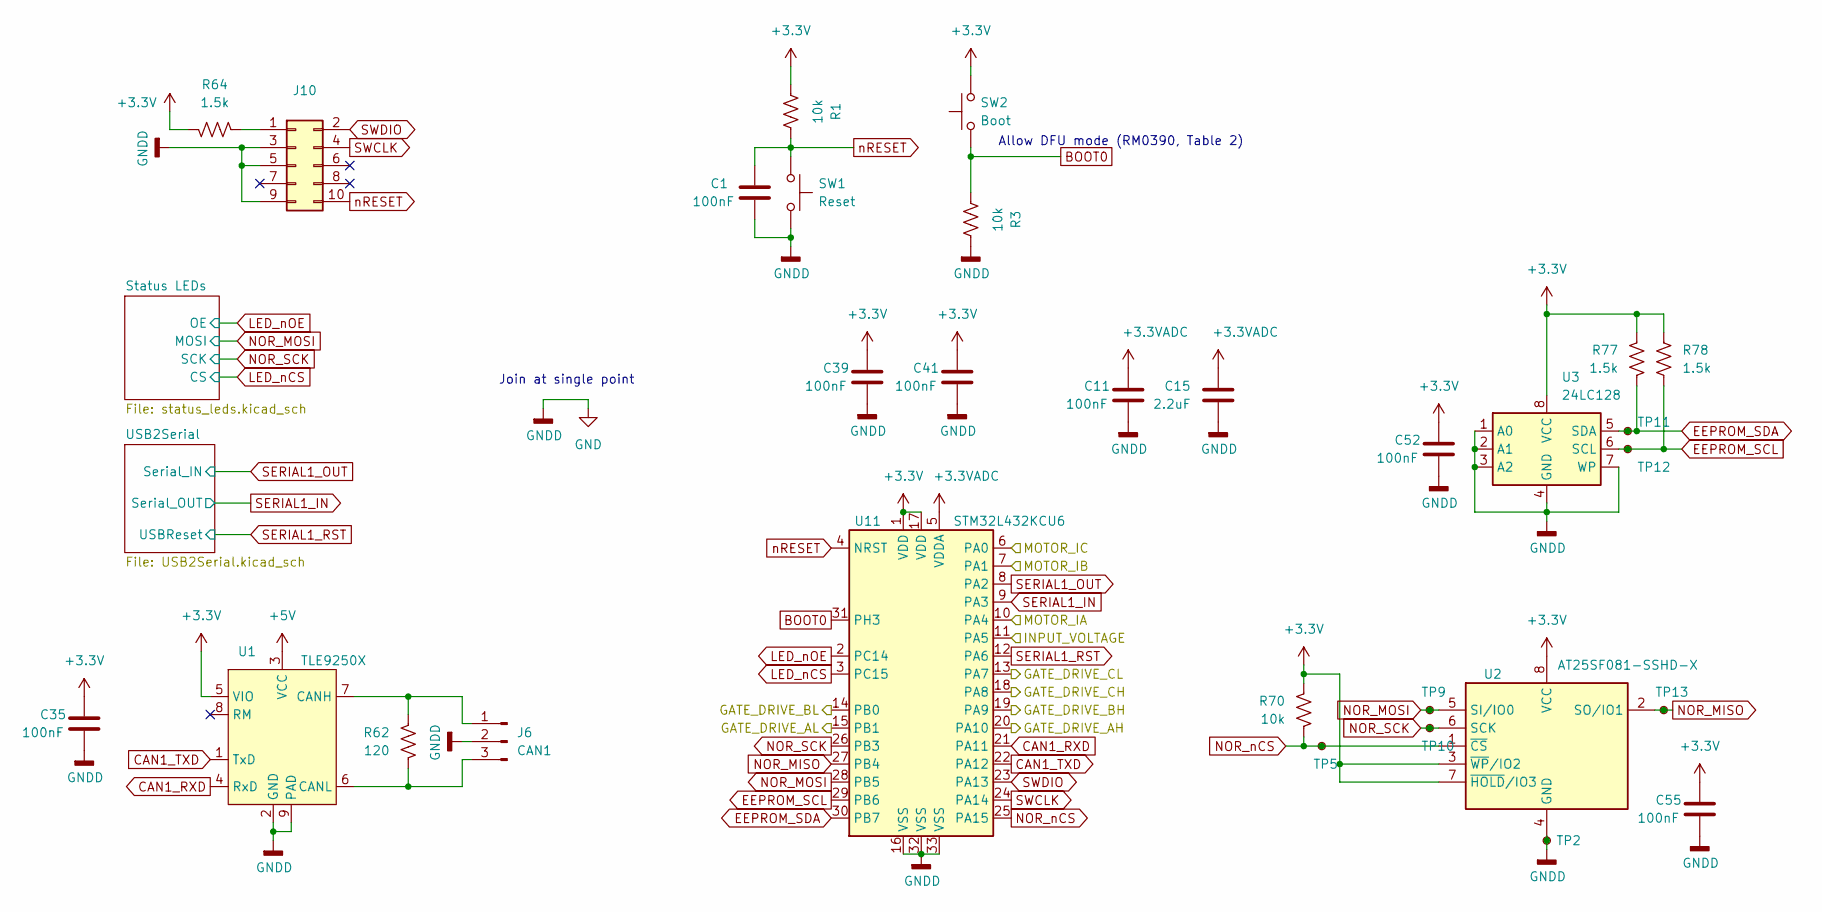
[picture p9: schematic microcontroller.kicad_sch]

Parts:
C1, C11, C35, C39, C41, C52, C55: 100nF; C_0402_1005Metric; LCSC C307331
C15: 2.2uF; C_0805_2012Metric; LCSC C49217
J6: CAN1; JST_PH_B3B-PH-K_1x03_P2.00mm_Vertical; DigiKey A100035-ND
J10: PinHeader_2x05_P1.27mm_Vertical; DigiKey 609-3712-ND
R1, R3, R70: 10k; R_0402_1005Metric; LCSC C25744
R62: 120; R_0402_1005Metric; LCSC C25079
R64, R77, R78: 1.5k; R_0402_1005Metric; LCSC C25867
SW1: Reset; SW_SPST_PTS810; DigiKey CKN10502CT-ND
SW2: Boot; SW_SPST_PTS810; DigiKey CKN10502CT-ND
TP2, TP13: NOR_MISO; TestPoint_Pad_D1.0mm
TP5: NOR_nCS; TestPoint_Pad_D1.0mm
TP9: NOR_MOSI; TestPoint_Pad_D1.0mm
TP10: NOR_SCK; TestPoint_Pad_D1.0mm
TP11: EEPROM_SDA; TestPoint_Pad_D1.0mm
TP12: EEPROM_SCL; TestPoint_Pad_D1.0mm
U1: TLE9250X; HVSON-8-1EP_3x3mm_P0.65mm_EP1.6x2.4mm; DigiKey 448-TLE9250XLEXUMA1CT-ND
U2: AT25SF081-SSHD-X; SOIC-8_3.9x4.9mm_P1.27mm; DigiKey 1265-AT25SF081B-SSHD-B-ND
U3: 24LC128; MSOP-8_3x3mm_P0.65mm; DigiKey 24LC128T-E/MSCT-ND
U11: STM32L432KCU6; QFN-32-1EP_5x5mm_P0.5mm_EP3.45x3.45mm; LCSC C1337280

Connections:
+3.3V: C35.2, C39.2, C41.2, C52.2, C55.2, R1.2, R64.2, R70.2, R77.2, R78.1, SW2.2, U1.5 (VIO), U2.3 (~WP/IO2), U2.7 (~HOLD/IO3), U2.8 (VCC), U3.8 (VCC), U11.1 (VDD), U11.17 (VDD); also elsewhere on the board
+3.3VADC: C11.2, C15.2, U11.5 (VDDA); also elsewhere on the board
+5V: U1.3 (VCC); also elsewhere on the board
/MCU/GATE_DRIVE_AH: U11.20 (PA10); also elsewhere on the board
/MCU/GATE_DRIVE_AL: U11.15 (PB1); also elsewhere on the board
/MCU/GATE_DRIVE_BH: U11.19 (PA9); also elsewhere on the board
/MCU/GATE_DRIVE_BL: U11.14 (PB0); also elsewhere on the board
/MCU/GATE_DRIVE_CH: U11.18 (PA8); also elsewhere on the board
/MCU/GATE_DRIVE_CL: U11.13 (PA7); also elsewhere on the board
/MCU/INPUT_VOLTAGE: U11.11 (PA5); also elsewhere on the board
/MCU/MOTOR_IA: U11.10 (PA4); also elsewhere on the board
/MCU/MOTOR_IB: U11.7 (PA1); also elsewhere on the board
/MCU/MOTOR_IC: U11.6 (PA0); also elsewhere on the board
BOOT0: R3.2, SW2.1, U11.31 (PH3)
CAN1_RXD: U1.4 (RxD), U11.21 (PA11)
CAN1_TXD: U1.1 (TxD), U11.22 (PA12)
EEPROM_SCL: R78.2, TP12.1, U3.6 (SCL), U11.29 (PB6)
EEPROM_SDA: R77.1, TP11.1, U3.5 (SDA), U11.30 (PB7)
GND: C1.1, C11.1, C15.1, C35.1, C39.1, C41.1, C52.1, C55.1, J6.2, J10.3, J10.5, J10.9, R3.1, SW1.2, TP2.1, U1.2 (GND), U1.9 (PAD), U2.4 (GND), U3.1 (A0), U3.2 (A1), U3.3 (A2), U3.4 (GND), U3.7 (WP), U11.16 (VSS), U11.32 (VSS), U11.33 (VSS); also elsewhere on the board
LED_nCS: U11.3 (PC15); also elsewhere on the board
LED_nOE: U11.2 (PC14); also elsewhere on the board
NOR_MISO: TP13.1, U2.2 (SO/IO1), U11.27 (PB4)
NOR_MOSI: TP9.1, U2.5 (SI/IO0), U11.28 (PB5); also elsewhere on the board
NOR_SCK: TP10.1, U2.6 (SCK), U11.26 (PB3); also elsewhere on the board
NOR_nCS: R70.1, TP5.1, U2.1 (~CS), U11.25 (PA15)
unnamed: J6.1, R62.2, U1.7 (CANH)
unnamed: J6.3, R62.1, U1.6 (CANL)
unnamed: J10.1, R64.1
SERIAL1_IN: U11.9 (PA3); also elsewhere on the board
SERIAL1_OUT: U11.8 (PA2); also elsewhere on the board
SERIAL1_RST: U11.12 (PA6); also elsewhere on the board
SWCLK: J10.4, U11.24 (PA14)
SWDIO: J10.2, U11.23 (PA13)
nRESET: C1.2, J10.10, R1.1, SW1.1, U11.4 (NRST)

Notes on the sheet:
Join at single point
Allow DFU mode (RM0390, Table 2)

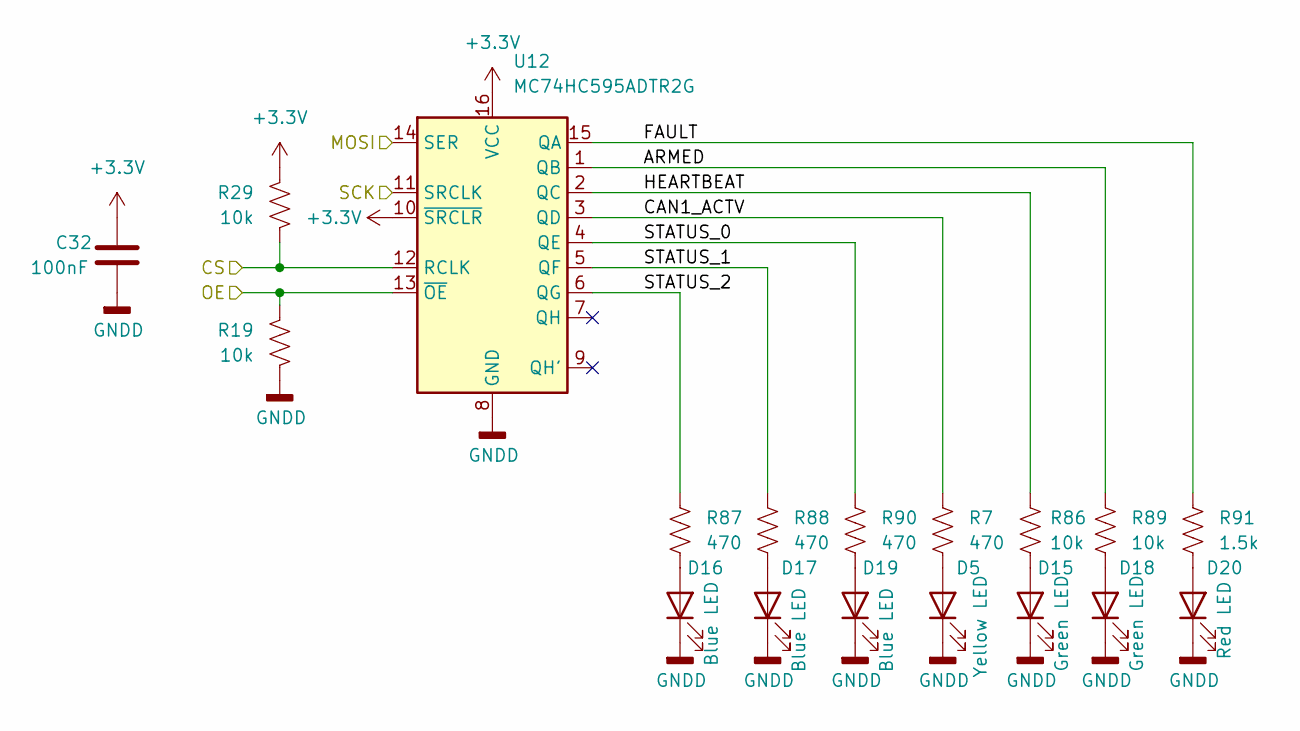
[picture p10: schematic status_leds.kicad_sch]

Parts:
C32: 100nF; C_0402_1005Metric; LCSC C307331
D5: Yellow LED; D_0603_1608Metric; LCSC C72038
D15, D18: Green LED; D_0603_1608Metric; LCSC C72043
D16, D17, D19: Blue LED; D_0603_1608Metric; LCSC C72041
D20: Red LED; D_0603_1608Metric; LCSC C2286
R7, R87, R88, R90: 470; R_0402_1005Metric; LCSC C25117
R19, R29, R86, R89: 10k; R_0402_1005Metric; LCSC C25744
R91: 1.5k; R_0402_1005Metric; LCSC C25867
U12: MC74HC595ADTR2G; TSSOP-16_4.4x5mm_P0.65mm; LCSC C100027

Connections:
+3.3V: C32.2, R29.2, U12.10 (~SRCLR), U12.16 (VCC); also elsewhere on the board
/MCU/Status LEDs/ARMED: R89.1, U12.1 (QB)
/MCU/Status LEDs/CAN1_ACTV: R7.1, U12.3 (QD)
/MCU/Status LEDs/FAULT: R91.1, U12.15 (QA)
/MCU/Status LEDs/HEARTBEAT: R86.1, U12.2 (QC)
/MCU/Status LEDs/STATUS_0: R90.1, U12.4 (QE)
/MCU/Status LEDs/STATUS_1: R88.1, U12.5 (QF)
/MCU/Status LEDs/STATUS_2: R87.1, U12.6 (QG)
GND: C32.1, D5.1 (K), D15.1 (K), D16.1 (K), D17.1 (K), D18.1 (K), D19.1 (K), D20.1 (K), R19.1, U12.8 (GND); also elsewhere on the board
LED_nCS: R29.1, U12.12 (RCLK); also elsewhere on the board
LED_nOE: R19.2, U12.13 (~OE); also elsewhere on the board
NOR_MOSI: U12.14 (SER); also elsewhere on the board
NOR_SCK: U12.11 (SRCLK); also elsewhere on the board
unnamed: D5.2 (A), R7.2
unnamed: D15.2 (A), R86.2
unnamed: D16.2 (A), R87.2
unnamed: D17.2 (A), R88.2
unnamed: D18.2 (A), R89.2
unnamed: D19.2 (A), R90.2
unnamed: D20.2 (A), R91.2

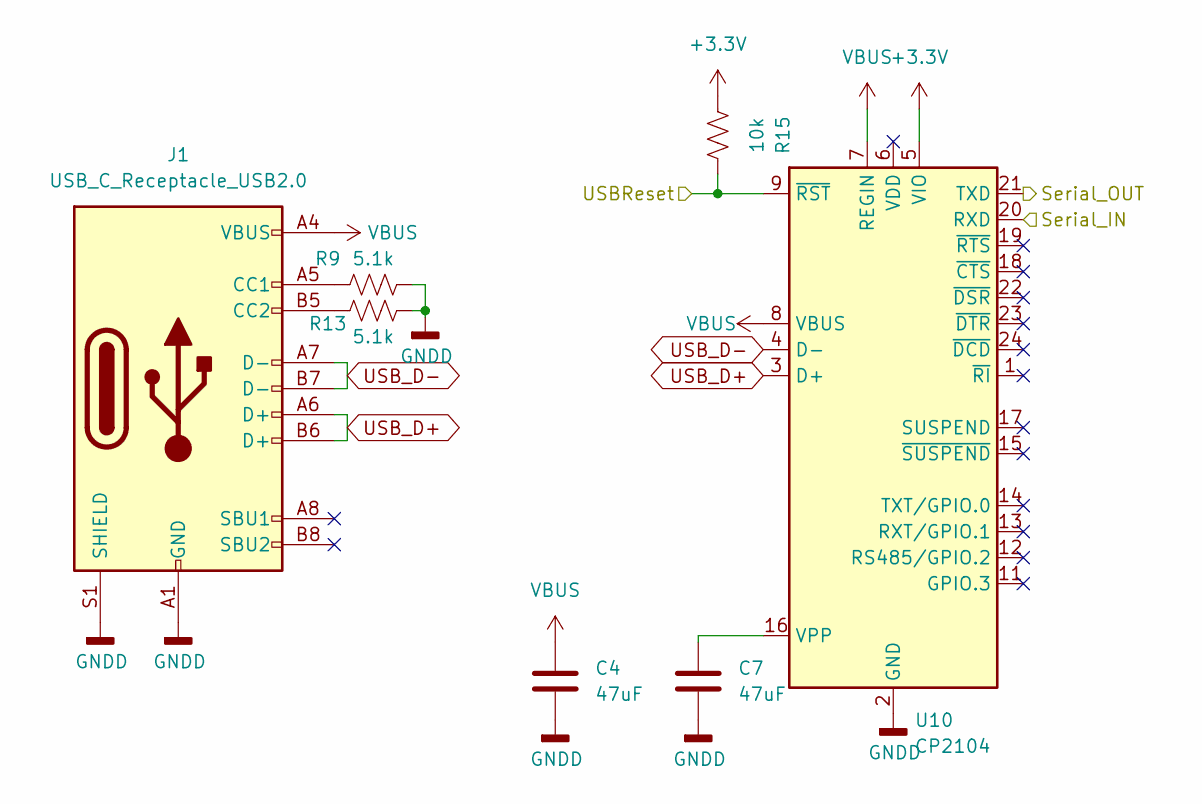
[picture p11: schematic USB2Serial.kicad_sch]

Parts:
C4, C7: 47uF; C_0805_2012Metric; LCSC C16780
J1: USB_C_Receptacle_USB2.0; USB_C_Receptacle_GCT_USB4085
R9, R13: 5.1k; R_0402_1005Metric; LCSC C25905
R15: 10k; R_0402_1005Metric; LCSC C25744
U10: CP2104; QFN-24-1EP_4x4mm_P0.5mm_EP2.6x2.6mm

Connections:
+3.3V: R15.2, U10.5 (VIO); also elsewhere on the board
GND: C4.2, C7.2, J1.A1 (GND), J1.A12 (GND), J1.B1 (GND), J1.B12 (GND), J1.S1 (SHIELD), R9.1, R13.2, U10.2 (GND), U10.25 (GND); also elsewhere on the board
unnamed: C7.1, U10.16 (VPP)
unnamed: J1.A5 (CC1), R9.2
unnamed: J1.B5 (CC2), R13.1
SERIAL1_IN: U10.21 (TXD); also elsewhere on the board
SERIAL1_OUT: U10.20 (RXD); also elsewhere on the board
SERIAL1_RST: R15.1, U10.9 (~RST); also elsewhere on the board
USB_D+: J1.A6 (D+), J1.B6 (D+), U10.3 (D+)
USB_D-: J1.A7 (D-), J1.B7 (D-), U10.4 (D-)
VBUS: C4.1, J1.A4 (VBUS), J1.A9 (VBUS), J1.B4 (VBUS), J1.B9 (VBUS), U10.7 (REGIN), U10.8 (VBUS); also elsewhere on the board

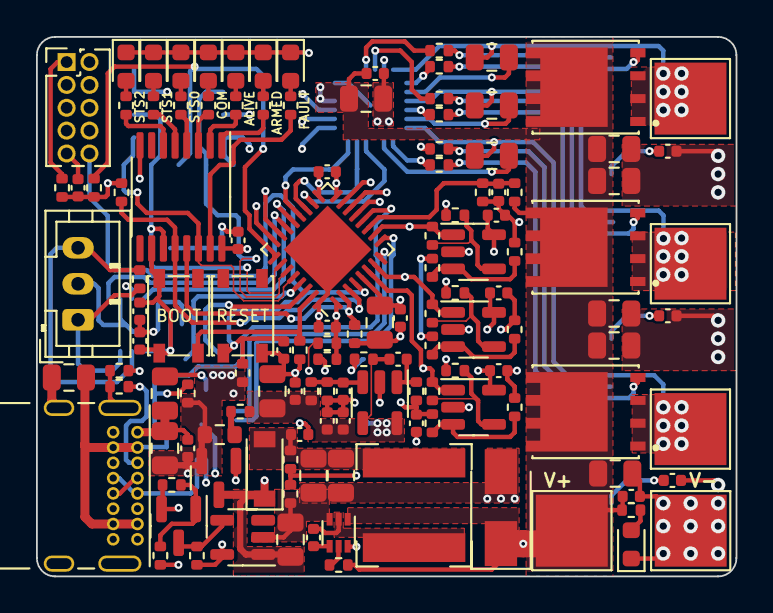
[picture p12: board hw/pcb/OrbitESC/OrbitESC.kicad_pcb from above]

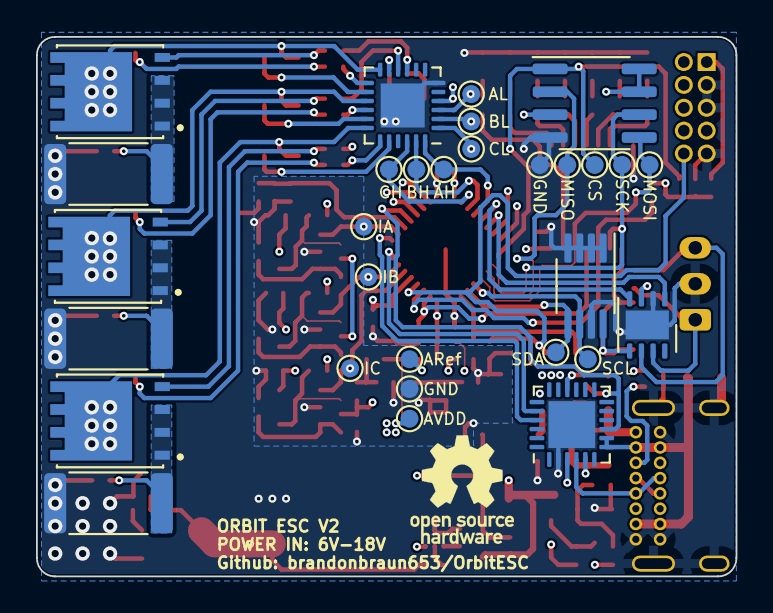
[picture p13: board hw/pcb/OrbitESC/OrbitESC.kicad_pcb from below]

Board: 4 copper layers, 38.9 x 30.0 mm, 159 parts (30 on the bottom side), 95 nets.
