brandonbraun653/OrbitESC/hw/stm32cubemx/stm32f446ret6.ioc

Mcu.UserName=STM32F446RETx
PA0-WKUP.Signal=ADCx_IN0
PA1.Signal=ADCx_IN1
PA10.Signal=S_TIM1_CH3
PA11.Signal=CAN1_RX
PA12.Signal=CAN1_TX
PA13.Signal=SYS_JTMS-SWDIO
PA14.Signal=SYS_JTCK-SWCLK
PA15.Signal=SPI1_NSS
PA2.Signal=ADCx_IN2
PA3.Signal=ADCx_IN3
PA4.Signal=ADCx_IN4
PA5.Signal=ADCx_IN5
PA7.Signal=TIM1_CH1N
PA8.Signal=S_TIM1_CH1
PA9.Signal=S_TIM1_CH2
PB0.Signal=TIM1_CH2N
PB1.Signal=TIM1_CH3N
PB10.GPIO_Label=SDIO_DET
PB10.Signal=GPIO_Input
PB12.GPIO_Label=USB_OTG_HS_RESET
PB12.Signal=GPIO_Output
PB13.Signal=USB_OTG_HS_VBUS
PB14.Signal=USB_OTG_HS_DM
PB15.Signal=USB_OTG_HS_DP
PB3.Signal=SPI1_SCK
PB4.Signal=SPI1_MISO
PB5.Signal=SPI1_MOSI
PB6.GPIO_Label=Fault
PB6.Signal=GPIO_Output
PB7.GPIO_Label=Armed
PB7.Signal=GPIO_Output
PB8.GPIO_Label=Heartbeat
PB8.Signal=GPIO_Output
PB9.GPIO_Label=CAN Activity
PB9.Signal=GPIO_Output
PC0.Signal=ADCx_IN10
PC1.Signal=ADCx_IN11
PC10.Signal=SDIO_D2
PC11.Signal=SDIO_D3
PC12.Signal=SDIO_CK
PC13.GPIO_Label=USB Activity
PC13.Signal=GPIO_Output
PC2.Signal=ADCx_IN12
PC3.Signal=ADCx_IN13
PC6.Signal=USART6_TX
PC7.Signal=USART6_RX
PC8.Signal=SDIO_D0
PC9.Signal=SDIO_D1
PD2.Signal=SDIO_CMD
PH0-OSC_IN.Signal=RCC_OSC_IN
PH1-OSC_OUT.Signal=RCC_OSC_OUT
