brandonbraun653/OrbitESC/(commit log)

2022-02-05 Add some attempts at simulating a half-bridge driver
    [HalfBridgeDriver.kicad_pcb, HalfBridgeDriver.kicad_sch]
2022-02-06 Switched debuger target over to SWD for development board
2022-02-12 Update the project pin configuration
2022-02-24 Configure CAN filters to start testing
2022-03-05 Basic CAN bus communication working
2022-03-06 Work on L4 DMA drivers
2022-03-10 Kinda working ADC sampling with DMA
2022-03-16 Save work. Missing i2c, pwm and motor drivers
    [thor_user_config.hpp]
2022-03-27 Start testing out I2C
2022-04-01 I2C memory working
2022-04-02 Work on the ADC driver
2022-05-15 Working PWM output on status LED
2022-05-24 Start working on python motor modeling
2022-06-09 Wrote another motor sim, same bad behavior...
2022-07-03 Get the ADC sampling triggered at 30kHz via a timer
2022-07-10 Hook into the DMA based ADC sampling
2022-07-17 Worked out more of the 3phase timer. Still not working
    [foc_driver.cpp, orbit_timer.cpp]
2022-07-18 Triggering ADC from motor timer, but outputs not driving yet.
2022-07-20 Got the motor turning low speed open loop!
2022-07-22 Fixed timer bug. Some tinkering.
    [adc_runtime.cpp, bootup.cpp, foc_driver.cpp, foc_driver.hpp, orbit_adc.cpp]
2022-07-25 Add voltage streaming message
2022-07-26 Sync for starting to work on ADC measurements
2022-07-27 Swap IO pins back to dev board configuration. Fix HW driver bugs.
    [bootup.cpp, orbit_gpio.cpp, orbit_timer.cpp, plotter.py, tsk_idle.cpp]
2022-08-01 Prototype some of the control algorithm
2022-08-08 Add notes about python version matching with arm-none-eabi-gdb-py3
2022-08-09 Add high level EEPROM init/mount calls
2022-08-15 Live plot estimated motor speed. It's not great.
2022-08-17 Cleaned up ESC pipe. Add attempt at mode switching
2022-08-19 Got the motor controller to run the PARK/ALIGN stage
2022-08-21 Got the motor to ramp, though it's a bit slow and has trouble with transients
2022-08-22 Switch to in development branch of Aurora for testing persistent memory
2022-08-26 Switch to the STM32L432 KC variant for more flash memory
2022-08-26 Add initial PCB files
    [OrbitESC.kicad_pcb, OrbitESC.kicad_sch, microcontroller.kicad_sch, output_stage.kicad_sch, power_stage.kicad_sch, power_supply.kicad_sch]
2022-08-27 Start designing power stage
    [OrbitESC.kicad_pcb, OrbitESC.kicad_sch, microcontroller.kicad_sch, output_stage.kicad_sch]
2022-08-29 Add power stage components
    [OrbitESC.kicad_pcb, OrbitESC.kicad_sch, microcontroller.kicad_sch, output_stage.kicad_sch, power_stage.kicad_sch, power_supply.kicad_sch]
2022-08-29 Initial planning of MCU connections
    [OrbitESC.kicad_pcb, OrbitESC.kicad_sch, microcontroller.kicad_sch]
2022-08-29 Start working on USB interface
    [OrbitESC.kicad_sch, microcontroller.kicad_sch, power_stage.kicad_sch, usb.kicad_sch]
2022-08-30 Connect USB to MCU
    [OrbitESC.kicad_sch, microcontroller.kicad_sch, usb.kicad_sch]
2022-09-02 Clean up UART/USART
2022-09-04 Fill out majority of schematic
    [OrbitESC.kicad_sch, input_button.kicad_sch, microcontroller.kicad_sch, power_stage.kicad_sch, status_leds.kicad_sch, usb.kicad_sch]
2022-09-04 Add test pads
    [OrbitESC.kicad_sch, microcontroller.kicad_sch, power_stage.kicad_sch]
2022-09-06 Schematic checklist runthrough
    [OrbitESC.kicad_sch, input_button.kicad_sch, microcontroller.kicad_sch, output_stage.kicad_sch, power_stage.kicad_sch, usb.kicad_sch]
2022-09-06 Update PCB to match schematic
    [OrbitESC.kicad_pcb, microcontroller.kicad_sch, power_stage.kicad_sch, power_supply.kicad_sch, status_leds.kicad_sch, usb.kicad_sch]
2022-09-06 Start routing power stage
    [OrbitESC.kicad_pcb, OrbitESC.kicad_sch, power_stage.kicad_sch, power_supply.kicad_sch]
2022-09-07 Route more of the power stage
    [OrbitESC.kicad_pcb]
2022-09-08 Compile for STM32F4 and L4 target development boards
2022-09-08 rework power stage
    [OrbitESC.kicad_pcb]
2022-09-11 Redo power stage layout. Start on power supplies
    [OrbitESC.kicad_pcb, power_stage.kicad_sch]
2022-09-12 Route analogs and power stage sections
    [OrbitESC.kicad_pcb, OrbitESC.kicad_sch, microcontroller.kicad_sch, output_stage.kicad_sch]
2022-09-12 Tentative component placement for remainder pieces
    [OrbitESC.kicad_pcb]
2022-09-13 Start rework of processor selection after realizing I can't afford manufacturing...
    [OrbitESC.kicad_pcb, OrbitESC.kicad_sch, input_button.kicad_sch, microcontroller.kicad_sch, output_stage.kicad_sch, power_stage.kicad_sch, status_leds.kicad_sch]
2022-09-13 Rework new processor
    [OrbitESC.kicad_pcb, OrbitESC.kicad_sch, USB2Serial.kicad_sch, microcontroller.kicad_sch, status_leds.kicad_sch]
2022-09-22 PCB cleanup
    [OrbitESC.kicad_pcb, USB2Serial.kicad_sch, microcontroller.kicad_sch, status_leds.kicad_sch]
2022-09-22 More routing of components
    [OrbitESC.kicad_pcb]
2022-09-23 First draft of routed PCB
    [OrbitESC.kicad_pcb, microcontroller.kicad_sch]
2022-09-23 Clean up DRC errors
    [OrbitESC.kicad_pcb]
2022-09-24 Finalize V1 of PCB
    [OrbitESC.kicad_pcb]
2022-09-30 Switch over to NODE1
2023-06-14 Squash feature/sync_current_ctrl/r0
    [CurrentSense.kicad_pcb, CurrentSense.kicad_sch, OrbitESC.kicad_pcb, OrbitESC.kicad_sch, OrbitESC_BOMCheckList.ods, USB2Serial.kicad_sch, input_button.kicad_sch, microcontroller.kicad_sch]
2023-06-21 Update schematic with a few discoveries from board bringup
    [microcontroller.kicad_sch, power_supply.kicad_sch]
2023-06-22 Sync before branch for new board mapping
2023-12-06 Add support for measuring/controlling phase voltage streaming
2023-12-15 Refactor the motor drivers to have a more explicit api
2023-12-27 Start adding subroutine for rotor initial position detection
2024-01-31 Add attempt at rotor initial position detection
2024-02-22 Current control debug session
2024-02-25 Force streaming of current control monitor data from ISR to help with debugging control loop.
2024-02-28 Added a socket based fake of the ZUSB serial interface for integration testing
2024-02-29 Validate simulated serial connection. Fix a few old time bugs.
    [bootup.cpp, com_app_tx.cpp, com_scheduler.cpp, com_scheduler.hpp, fixtures.py, orbit_data.cpp, orbit_data_defaults.hpp]
2024-03-01 Improve environment setup. Fix a few things with ADC conversions.
    [current_control.cpp, orbit_adc.cpp, orbit_instrumentation.cpp, sim_adc.cpp]
2024-03-04 Connect more of the motor model
2024-03-05 Get some simulation data streaming for the motor model.
2024-03-31 Sync some ideas from messing around
    [OrbitESC.kicad_sch, microcontroller.kicad_sch, output_stage.kicad_sch, power_stage.kicad_sch, power_supply.kicad_sch]
2024-04-10 Add some messing around with filtering
2024-04-15 Lunchtime filter design experimentation
2024-04-20 Improve filter design iteration support. Still not getting good estimator output though.
2024-04-20 Save some more stuff
    [system_observer_monitor.csv]
2024-04-22 Try out the position derivative and filtering models
2024-04-24 sketch some bare minimum prototype for switch to closed loop control?
2024-04-25 Fix some issues with time accouting in ramp up. Not cleanly transitioning to closed loop control at all.
    [current_control.cpp, speed_control.cpp, test_mode_transitions.py]
2024-04-26 Little more messing with the control. Still not working.
    [current_control.cpp, speed_control.cpp, speed_control.hpp]
2025-10-04 Fix clangd based intellisense
    [sim_usb_serial.cpp]
2025-10-09 Add prototype trace interface (NEEDS REVIEW)
2025-10-09 Integrate trace module with compilation
2025-10-10 Add C/C++ code snippets for VSCode, refactor trace module, and implement MATLAB simulation callbacks
2025-10-15 Start working on timer integrations
2025-10-22 Clean up matlab integration with new timer behavior
2025-10-22 Add a motor to the matlab model. Close the sim data loop.
2025-10-23 Improve motor simulation. Sort of replicate some motor ramp graphs I observed in HW testing.
2025-10-24 Take measurements of real motor and plug into sim. Trying to figure out open loop startup.
2025-10-24 Realized my control loop is all wrong for ramping. Need to update.
    [current_control.cpp, foc_data.cpp, foc_data.hpp]
2025-10-27 Clean up model directory. FINALLY figured out current loop control.
2025-11-08 Figure out a few more things with PID control stability
2025-11-29 Improve PID tuning and ramp behavior
2025-12-21 Minor updates to support switching from current control to speed control
2026-01-18 Improve motor control current loop bandwidth restrictions
2026-07-30 Fix the embedded build
    [current_control.cpp, orbit_adc.cpp, orbit_trace.cpp, tasks.cpp]
